ctolleson/Fan-Controller/board_initial.png

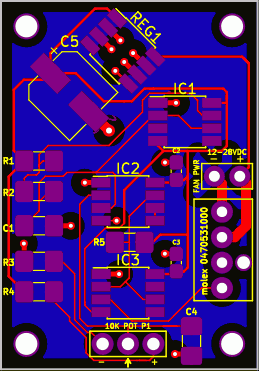
board_initial.png
