ctolleson/Fan-Controller/fanschematic-2.png

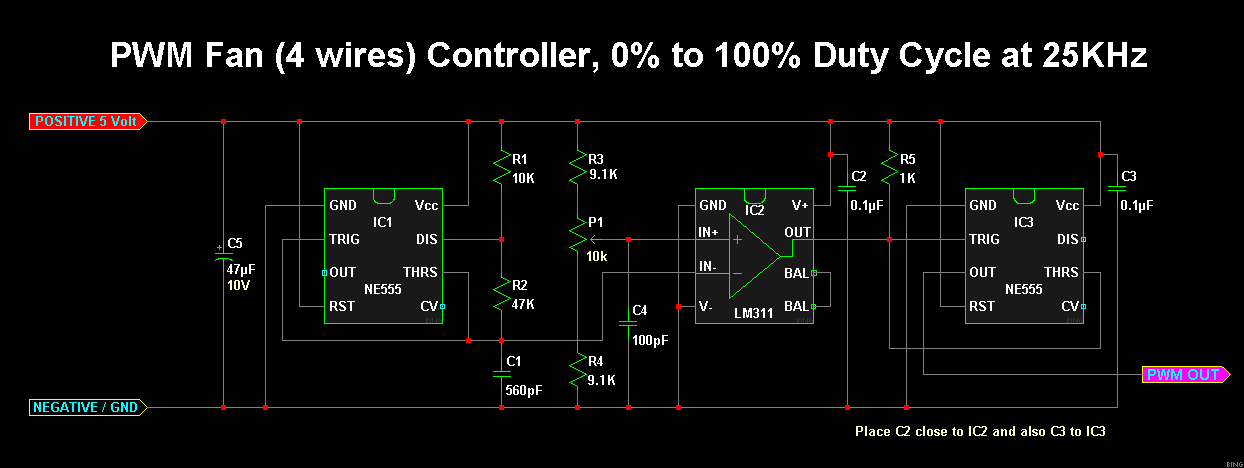
fanschematic-2.png
