ctolleson/Fan-Controller/JLCPCB_Quote/pcb_stencil_saved_cart.png

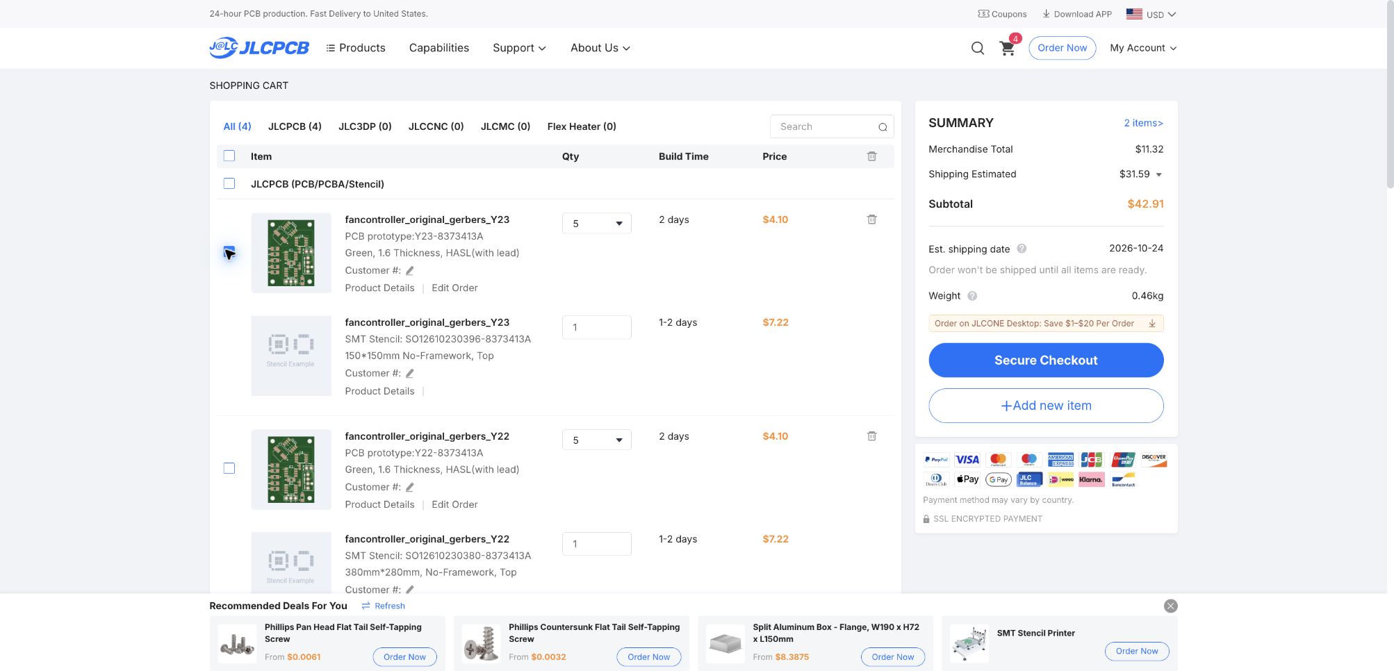
JLCPCB_Quote/pcb_stencil_saved_cart.png
