ctolleson/Fan-Controller/JLCPCB_Quote/placement_preview.png

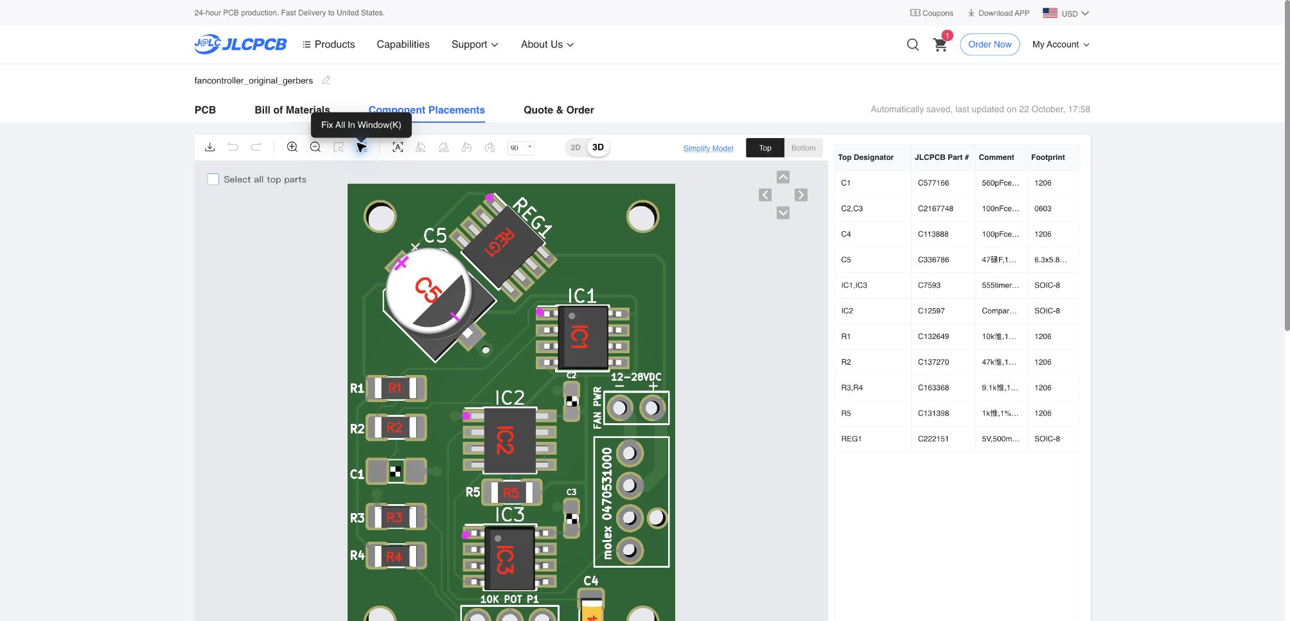
JLCPCB_Quote/placement_preview.png
