ctolleson/Fan-Controller/JLCPCB_Quote/quote_59_91.png

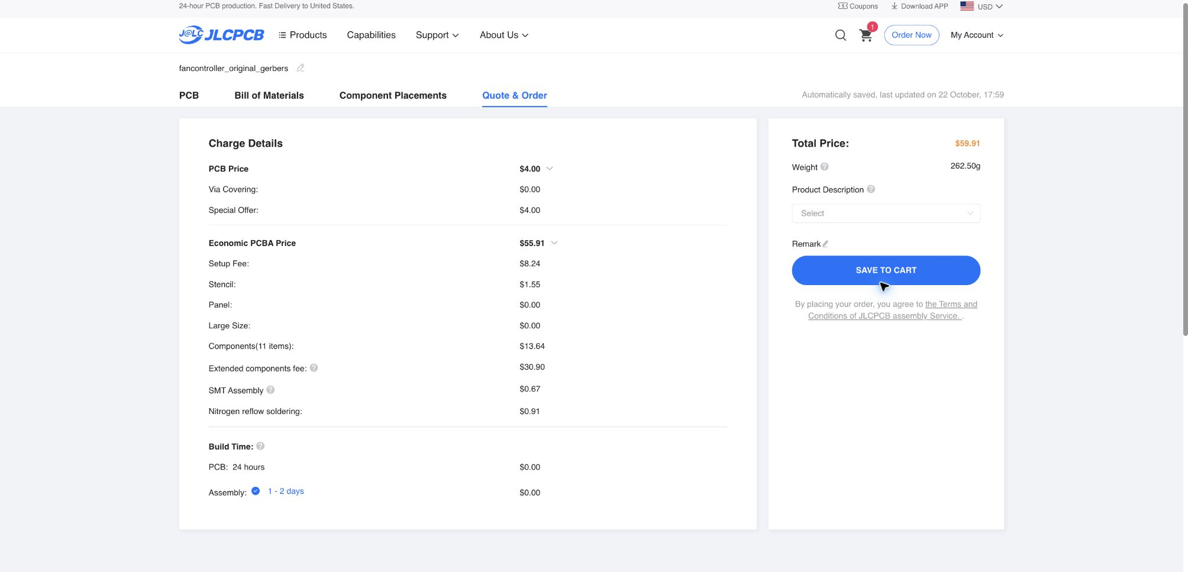
JLCPCB_Quote/quote_59_91.png
