ctolleson/Fan-Controller/fancontroller_BOM_populated.xlsx

Sheet: PCB Assembly
References | Qty/board | Value / description | Original or candidate MPN | Manufacturer | KiCad footprint | LCSC code | Assembly | Match status | Review note | Source URL
REG1 | 1 | 5 V, 500 mA LDO regulator | KF50BD-TR | STMicroelectronics | Recovered2018:SOIC-8_3.9x4.9mm_P1.27mm | C222151 | SMT | Stocked quote replacement; 12 V only | Same pinout and active-low inhibit. 500 mA; input limit 20 V. Original 12-28 V silk is not valid for this build. | https://www.st.com/resource/en/datasheet/kfxx.pdf
C1 | 1 | 560 pF ceramic capacitor | CC1206JRNPO9BN561 | Yageo | Recovered2018:C_1206_3216Metric_Pad1.42x1.75mm_HandSolder | C577166 | SMT | Stocked quote replacement | 560 pF, 50 V, NP0, 5%, 1206. Replaces original 10% X7R timing capacitor. | https://jlcpcb.com/partdetail/YAGEO-CC1206JRNPO9BN561/C577166
C2, C3 | 2 | 100 nF ceramic capacitor | C0603C104K3RALTU | KEMET | Recovered2018:C_0603_1608Metric_Pad1.05x0.95mm_HandSolder | C2167748 | SMT | Exact MPN; verify stock | Original BOM suggested this part for both reference designators. | https://www.lcsc.com/product-detail/C2167748.html
C4 | 1 | 100 pF ceramic capacitor | CC1206JRNPOBBN101 | Yageo | Recovered2018:C_1206_3216Metric_Pad1.42x1.75mm_HandSolder | C113888 | SMT | Stocked quote replacement | 100 pF, 500 V, NP0, 5%, 1206. Retains capacitance, voltage rating and package. | https://jlcpcb.com/partdetail/YAGEO-CC1206JRNPOBBN101/C113888
C5 | 1 | 47 µF, 35 V polarized aluminum capacitor | EEEFK1V470AP | Panasonic | Recovered2018:CP_Elec_6.3x5.8 | C336786 | SMT | Stocked quote replacement | Same 6.3x5.8 mm case; 0.36 ohm impedance. Rated 2000 h at 105 C versus original 5000 h. Native polarity 315 degrees. | https://industrial.panasonic.com/ww/products/pt/aluminum-cap-smd/models/EEEFK1V470AP
IC1, IC3 | 2 | 555 timer, SOIC-8 | NE555DR | Texas Instruments | Recovered2018:SOIC-8_3.9x4.9mm_P1.27mm | C7593 | SMT | Exact MPN; verify stock | Two devices shown in both schematic image and BOM. | https://www.lcsc.com/product-detail/C7593.html
IC2 | 1 | Comparator, SOIC-8 | LM311DR | Texas Instruments | Recovered2018:SOIC-8_3.9x4.9mm_P1.27mm | C12597 | SMT | Exact MPN; verify stock | Pin mapping and supply wiring still need reconstruction. | https://www.lcsc.com/product-detail/C12597.html
R1 | 1 | 10 kΩ, 1%, 1206 resistor | RC1206FR-0710KL | Yageo | Recovered2018:R_1206_3216Metric_Pad1.42x1.75mm_HandSolder | C132649 | SMT | Exact MPN; verify stock | Original BOM test-circuit part. | https://www.lcsc.com/product-detail/C132649.html
R2 | 1 | 47 kΩ, 1%, 1206 resistor | RC1206FR-0747KL | Yageo | Recovered2018:R_1206_3216Metric_Pad1.42x1.75mm_HandSolder | C137270 | SMT | Exact MPN; verify stock | Original BOM test-circuit part. | https://www.lcsc.com/product-detail/C137270.html
R3, R4 | 2 | 9.1 kΩ, 1%, 1206 resistor | RC1206FR-079K1L | Yageo | Recovered2018:R_1206_3216Metric_Pad1.42x1.75mm_HandSolder | C163368 | SMT | Exact MPN matched to JLCPCB | Original BOM test-circuit part; obtain a current JLC/LCSC listing. | https://jlcpcb.com/partdetail/YAGEO-RC1206FR079K1L/C163368
R5 | 1 | 1 kΩ, 1%, 1206 resistor | RC1206FR-071KL | Yageo | Recovered2018:R_1206_3216Metric_Pad1.42x1.75mm_HandSolder | C131398 | SMT | Exact MPN; verify stock | Original BOM test-circuit part. | https://www.lcsc.com/product-detail/C131398.html
P1 | 1 | 10 kΩ potentiometer | PDF241-S425F-103B0 | Bourns |  | C6626952 | Through-hole / manual | Candidate; footprint open | Original BOM recommendation. Confirm pin spacing, shaft orientation, enclosure fit, and current availability. | https://lcsc.com/product-detail/Potentiometers-Variable-Resistors_BOURNS-PDF241-S425F-103B0_C6626952.html
J1 | 1 | 4-pin PWM fan header, 2.54 mm | 0470531000 | Molex |  |  | Through-hole / manual | MPN known; footprint open | Original BOM lists header. Confirm orientation and board mounting geometry. | https://www.molex.com/pdm_docs/sd/470531000_sd.pdf
J2 | 1 | 2-pin power input connector |  |  |  |  | Through-hole / manual | Part selection required | Inferred from the board image; omitted from the original BOM. Confirm pitch, polarity, and mating connector.

Sheet: Off-board options
Item | Qty per cable | MPN | Manufacturer | Purpose | Status / note | Source URL
4-pin mating housing | 1 | 0470541000 | Molex | Mates with J1 | Original BOM lists this as an optional cable part; not installed on PCB. | https://www.molex.com/pdm_docs/sd/470541000_sd.pdf
Gold crimp contact | 4 | 08-55-0102 | Molex | One per cable wire | Original BOM lists gold contacts; verify wire gauge and tooling.

Sheet: Read me
Fan controller BOM — reconstruction draft | 2026-10-22
Source | fancontroller_BOM.xlsx, fanschematic.png, fanschematic-2.png, board_initial.png, and supplied Gerbers/drills.
Quantity basis | Quantities in PCB Assembly are per one board. Off-board options are per one optional fan cable.
Status meaning | Exact MPN means the catalog listing names the original BOM part. It does not certify current stock, footprint fit, or JLCPCB assembly eligibility.
Project status | 17 schematic symbols remain unwired (ERC 79). Board has 14 SMT footprints matching original paste pads within 0.001 mm, but no nets (DRC 639). Courtyard violations: 0.
Build gate | Quote: five boards, 14 SMT parts each, 12 V supply. Stocked replacements are in PCB Assembly and JLCPCB_Quote/BOM.csv. P1/J1/J2 remain for hand assembly. Electrical validation is incomplete.
Known gap | J2 power connector is visible on the board image but absent from the supplied BOM.

Sheet: Placement draft
Reference | X on KiCad board (mm) | Y on KiCad board (mm) | Rotation (deg) | Max pad-center offset from supplied F.Paste (mm) | Source | Review status
C1 | 81.2800 | 160.9090 | 0 | 0.0000 | F.Paste Gerber | Pad centers and pad angles match supplied Gerber (<0.001 mm); quote geometry verified; electrical validation incomplete.
C2 | 94.9960 | 155.4480 | 90 | 0.0000 | F.Paste Gerber | Pad centers and pad angles match supplied Gerber (<0.001 mm); quote geometry verified; electrical validation incomplete.
C3 | 94.9960 | 164.5920 | 90 | 0.0000 | F.Paste Gerber | Pad centers and pad angles match supplied Gerber (<0.001 mm); quote geometry verified; electrical validation incomplete.
C4 | 96.5200 | 172.4295 | 90 | 0.0005 | F.Paste Gerber | Pad centers and pad angles match supplied Gerber (<0.001 mm); quote geometry verified; electrical validation incomplete.
C5 | 84.3280 | 147.5740 | 315 | 4.372800346e-07 | F.Paste Gerber | Pad centers and pad angles match supplied Gerber (<0.001 mm); quote geometry verified; electrical validation incomplete.
IC1 | 95.8596 | 150.5204 | 0 | 0.0004 | F.Paste Gerber | Pad centers and pad angles match supplied Gerber (<0.001 mm); quote geometry verified; electrical validation incomplete.
IC2 | 90.1700 | 158.4960 | 0 | 2.842170943e-14 | F.Paste Gerber | Pad centers and pad angles match supplied Gerber (<0.001 mm); quote geometry verified; electrical validation incomplete.
IC3 | 90.1700 | 167.6400 | 0 | 2.842170943e-14 | F.Paste Gerber | Pad centers and pad angles match supplied Gerber (<0.001 mm); quote geometry verified; electrical validation incomplete.
REG1 | 89.6366 | 143.4338 | 315 | 0.0002 | F.Paste Gerber | Pad centers and pad angles match supplied Gerber (<0.001 mm); quote geometry verified; electrical validation incomplete.
R1 | 81.2800 | 154.4320 | 0 | 0.0000 | F.Paste Gerber | Pad centers and pad angles match supplied Gerber (<0.001 mm); quote geometry verified; electrical validation incomplete.
R2 | 81.2800 | 157.4800 | 0 | 0.0000 | F.Paste Gerber | Pad centers and pad angles match supplied Gerber (<0.001 mm); quote geometry verified; electrical validation incomplete.
R3 | 81.2800 | 164.4650 | 0 | 0.0000 | F.Paste Gerber | Pad centers and pad angles match supplied Gerber (<0.001 mm); quote geometry verified; electrical validation incomplete.
R4 | 81.2800 | 167.5130 | 0 | 0.0000 | F.Paste Gerber | Pad centers and pad angles match supplied Gerber (<0.001 mm); quote geometry verified; electrical validation incomplete.
R5 | 90.3335 | 162.5600 | 0 | 0.0000 | F.Paste Gerber | Pad centers and pad angles match supplied Gerber (<0.001 mm); quote geometry verified; electrical validation incomplete.
P1 | 90.1700 | 172.7200 |  |  | PTH drill and board image | Pending; three 2.54 mm drill holes, board interface needs footprint selection
J1 | 99.5680 | 163.3220 |  |  | PTH drill and board image | Pending; four 2.54 mm drill holes, Molex footprint needs confirmation
J2 | 100.0760 | 155.9560 |  |  | PTH drill and board image | Pending; inferred two-pin power connector needs part selection
