ctolleson/Fan-Controller/fancontroller_BOM.xlsx

Bill of Materials
PWM Fan Controller
Part # | Schematic # | Mfg. part # | Package | Description | Notes
1 | REG1 | TS2938CS50 | 8-SOIC | 5v regulator | if >30 volt fan desired, use higher input v. regulator
2 | C1 | generic | SMD 1206 | 560pF cap | Part used in test circuit: C1206C561K5RAC7800
3 | C2 & C3 | generic | SMD 0603 | 0.1uF cap | Part used in test circuit: C0603C104K3RALTU
4 | C4 | generic | SMD 1206 | 100pF cap | Part used in test circuit: C1206C101KCRACTU
5 | C5 | UUL1A470MCL1GS | Radial, can 6.6 x 6.6mm | 10v 47uF cap | electrolytic, install correctly (correct polarity)
6 | IC1 & IC3 | NE555DR | 8-SOIC | 555 timer | Digikey part #: 296-6501-1-ND
7 | IC2 | LM311DR | 8-SOIC | lm311 comparator | Digikey part #: 296-1388-1-ND
8 | R1 | generic | SMD 1206 | 10K resistor | Part used in test circuit: RC1206FR-0710KL
9 | R2 | generic | SMD 1206 | 47K resistor | Part used in test circuit: RC1206FR-0747KL
10 | R3 & R4 | generic | SMD 1206 | 9.1K resistor | Part used in test circuit: RC1206FR-079K1L
11 | R5 | generic | SMD 1206 | 1K resistor | Part used in test circuit: RC1206FR-071KL
12 | 10K POT P1 | generic | - | 10k potentiometer | Recommended: PDF241-S425F-103B0
Molex male fan header 4 pin: 0470531000
Mating connector: 0470541000‎
Crimp pins, gold: 08-55-0102‎
