ctolleson/Fan-Controller/JLCPCB_Quote/bom_shortages.png

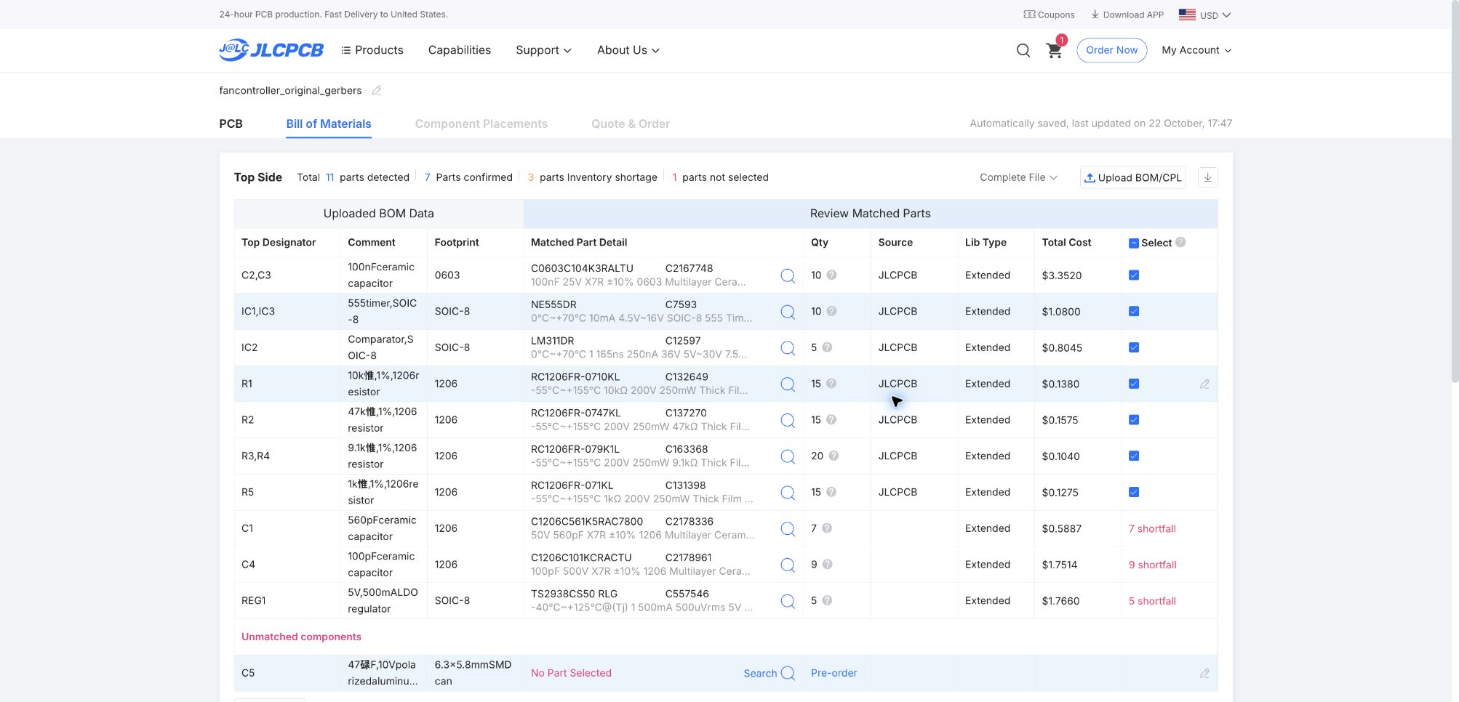
JLCPCB_Quote/bom_shortages.png
