ctolleson/Fan-Controller/JLCPCB_Quote/upload_step.png

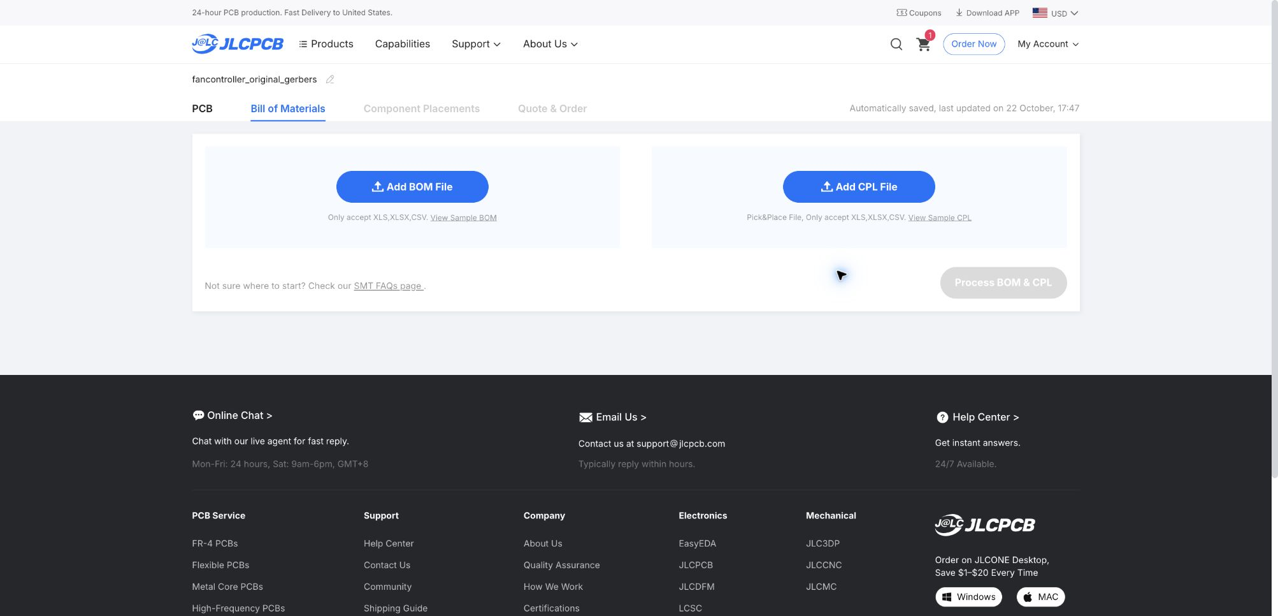
JLCPCB_Quote/upload_step.png
