ctolleson/Fan-Controller/KiCad/fancontroller/release_12v/schematic.pdf

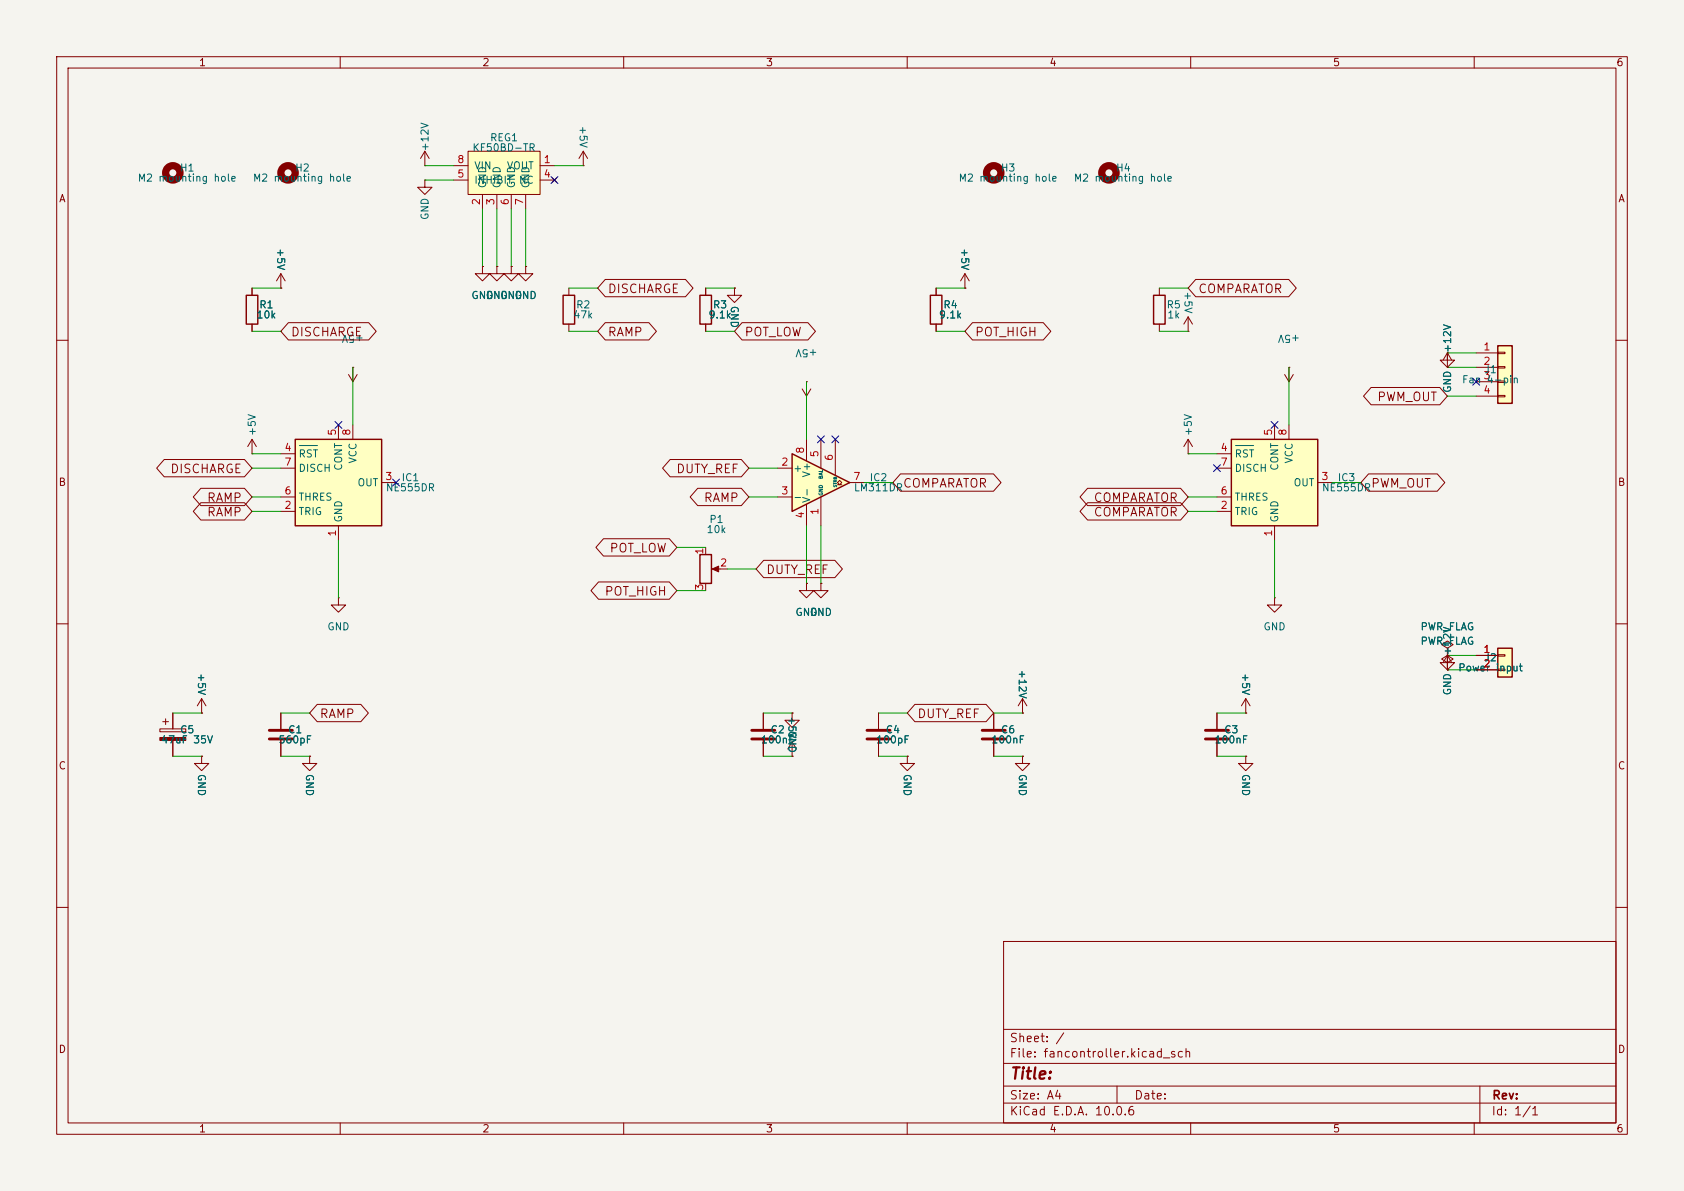
[picture p9: page 1]

Fan 4-pin GND GND

Size: A4 | Rev:
KiCad E.D.A. 10.0.6 | Id: 1/1
