ctolleson/Fan-Controller/KiCad/fancontroller/release_12v/board.pdf

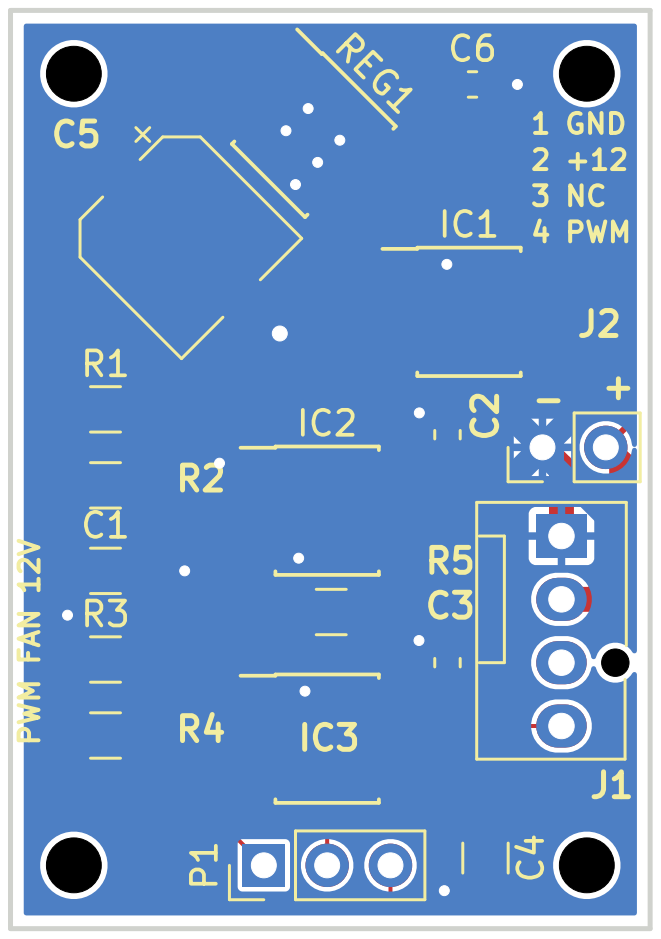
[picture p10: page 1]
