ctolleson/Fan-Controller/(list of files, drawings)

Other design files:
JLCPCB_Quote/pcb_stencil_quote.json
KiCad/fancontroller/release_12v/pcb_quality_gate.json
KiCad/fancontroller/release_12v/schematic_quality_gate.json
