ctolleson/Fan-Controller/KiCad/fancontroller/fancontroller.kicad_pcb

## KiCad design KiCad/fancontroller/fancontroller.kicad_pcb (2026-10-23)

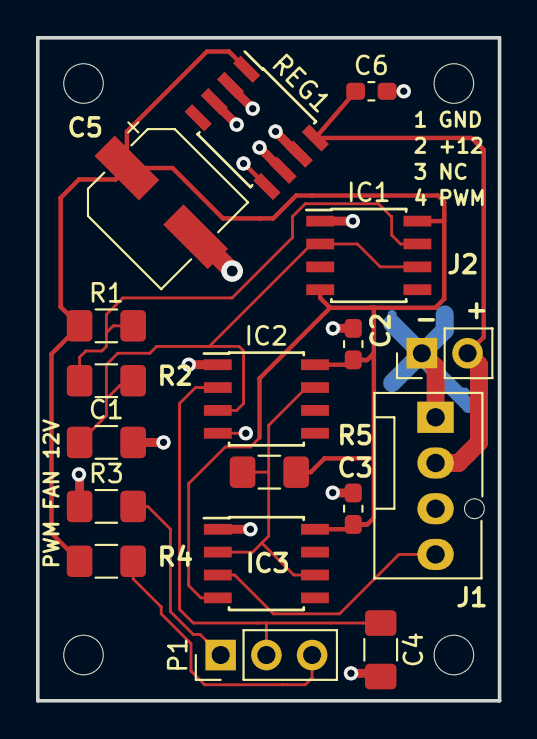
[picture p11: board fancontroller.kicad_pcb from above]

Board: 2 copper layers, 25.7 x 36.8 mm, 22 parts (0 on the bottom side), 10 nets.

Parts:
C1: 560pF; C_1206_3216Metric_Pad1.42x1.75mm_HandSolder
C2, C3, C6: 100nF; C_0603_1608Metric_Pad1.05x0.95mm_HandSolder
C4: 100pF; C_1206_3216Metric_Pad1.42x1.75mm_HandSolder
C5: 47uF 35V; CP_Elec_6.3x5.8
H1, H2, H3, H4: M2 mounting hole; MountingHole_2.2mm_M2
IC1, IC3: NE555DR; SOIC-8_3.9x4.9mm_P1.27mm
IC2: LM311DR; SOIC-8_3.9x4.9mm_P1.27mm
J1: Fan 4-pin; FanPinHeader_1x04_P2.54mm_Vertical
J2: Power input; PinHeader_1x02_P2.54mm_Vertical
P1: 10k; PinHeader_1x03_P2.54mm_Vertical
R1: 10k; R_1206_3216Metric_Pad1.42x1.75mm_HandSolder
R2: 47k; R_1206_3216Metric_Pad1.42x1.75mm_HandSolder
R3, R4: 9.1k; R_1206_3216Metric_Pad1.42x1.75mm_HandSolder
R5: 1k; R_1206_3216Metric_Pad1.42x1.75mm_HandSolder
REG1: KF50BD-TR; SOIC-8_3.9x4.9mm_P1.27mm

Connections:
+5V: C2.2, C3.1, C5.1, IC1.4, IC1.8, IC2.8, IC3.4, IC3.8, R1.1, R4.1, R5.2, REG1.1
+12V: C6.1, J1.2, J2.2, REG1.8
COMPARATOR: IC2.7, IC3.2, IC3.6, R5.1
DISCHARGE: IC1.7, R1.2, R2.1
DUTY_REF: C4.1, IC2.2, P1.2
GND: C1.2, C2.1, C3.2, C4.2, C5.2, C6.2, IC1.1, IC2.1, IC2.4, IC3.1, J1.1, J2.1, R3.1, REG1.2, REG1.3, REG1.5, REG1.6, REG1.7
POT_HIGH: P1.3, R4.2
POT_LOW: P1.1, R3.2
PWM_OUT: IC3.3, J1.4
RAMP: C1.1, IC1.2, IC1.6, IC2.3, R2.2
