ctolleson/Fan-Controller/(commit log)

2026-10-22 feat: preserve supplied PCB source materials
    [fancontroller-B.Cu.gbr, fancontroller-B.Mask.gbr, fancontroller-B.Paste.gbr, fancontroller-B.SilkS.gbr, fancontroller-Edge.Cuts.gbr, fancontroller-F.Cu.gbr, fancontroller-F.Mask.gbr, fancontroller-F.Paste.gbr]
2026-10-22 feat: create KiCad project shell for reconstructed fan controller
    [fancontroller.kicad_pcb, fancontroller.kicad_sch]
2026-10-22 feat: place recovered component symbols and values for BOM traceability
    [fancontroller.kicad_sch]
2026-10-22 feat: import supplied Gerber artwork into KiCad board for review
    [fancontroller.kicad_pcb]
2026-10-22 feat: populate sourced BOM and document KiCad reconstruction
    [fancontroller.kicad_sch, fancontroller_BOM_populated.xlsx]
2026-10-22 feat: place recovered SMD footprints and record draft assembly positions
    [fancontroller.kicad_pcb, fancontroller_BOM_populated.xlsx, fancontroller_pick_and_place_DRAFT.csv]
2026-10-22 feat: recover original footprints and correct pad placement geometry
    [fancontroller.kicad_pcb, fancontroller.kicad_sch, fancontroller_pick_and_place_DRAFT.csv]
2026-10-23 feat: obtain five-board SMT quote with stocked 12 V replacements
    [BOM.csv, BOM_uploaded_initial.csv, fancontroller_BOM_populated.xlsx, positions-kicad-mm.csv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]
2026-10-23 feat: reconstruct fan controller schematic connections and clear ERC
    [fancontroller.kicad_sch]
2026-10-23 feat: save PCB reconstruction checkpoint and detailed passdown
    [fancontroller.kicad_pcb, fancontroller.kicad_sch, pcb_stencil_quote.json]
2026-10-23 feat: clear native ERC and DRC and export revised 12 V assembly candidate
    [BOM.csv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]
